lionelbroche/cosi-measure/doc/Publications/README.md

A detailed description of COSI Measure V1.0 with supplementary videos can be found in the following publication:

[H. Han, R. Moritz, E. Oberacker, H. Waiczies, T. Niendorf and L. Winter, "Open Source 3D Multipurpose Measurement System with Submillimetre Fidelity and First Application in Magnetic Resonance", Scientific Reports, 7:13452, 2017](www.nature.com/articles/s41598-017-13824-z)
