lionelbroche/cosi-measure/src/src/Electronics.md

---
Details:
    Thumbnail: images/3Dview.bmp
    Time: 5 days
    Difficulty: Medium
    Skills:
      - Soldering
---

[M4x10 screws]:Parts.yaml#M4x10PanSteel
[No. 2 Phillips screwdriver]:Parts.yaml#Screwdriver_Philips_No2
# COSI-measure: Electronics

{{BOM}}

## Put screws into the widget {pagestep}

* Get a [No. 2 Phillips screwdriver]{Qty: 1, Cat: tool} ready
* Take three [M4x10 screws]{Qty: 3} and screw them into the [widget](widget.md){Qty: 1}

## Put more screws into the widget {pagestep}

* Find the [screwdriver][No. 2 Phillips screwdriver]{Qty: 1, Cat: tool} again
* Take two more [M4x10 screws]{Qty: 2} and screw them into the same widget
