lionelbroche/cosi-measure/doc/photos for Aberdeen/1000128496.jpg

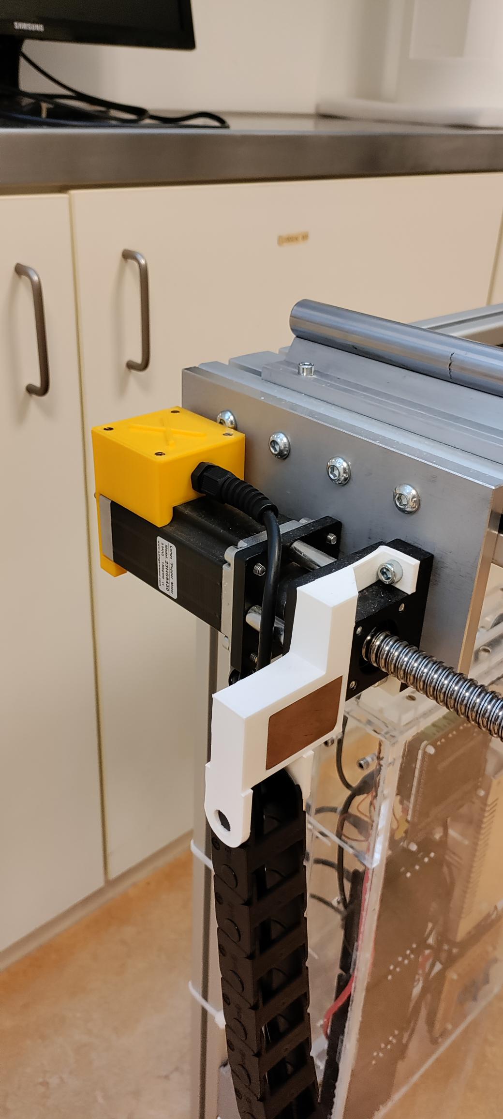
doc/photos for Aberdeen/1000128496.jpg
