lionelbroche/cosi-measure/doc/photos for Aberdeen/1000128497.jpg

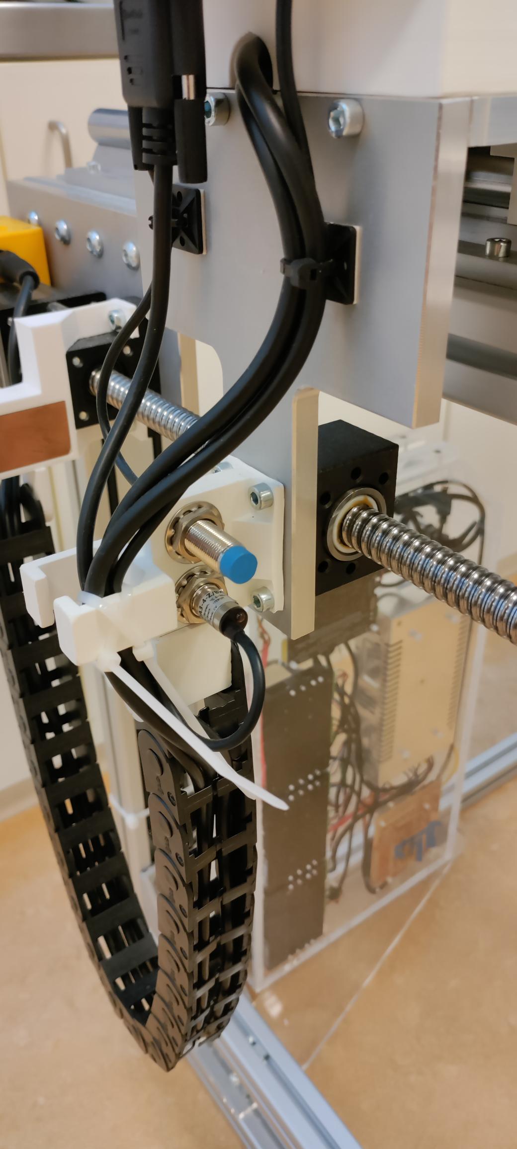
doc/photos for Aberdeen/1000128497.jpg
