lionelbroche/cosi-measure/doc/photos for Aberdeen/1000128498.jpg

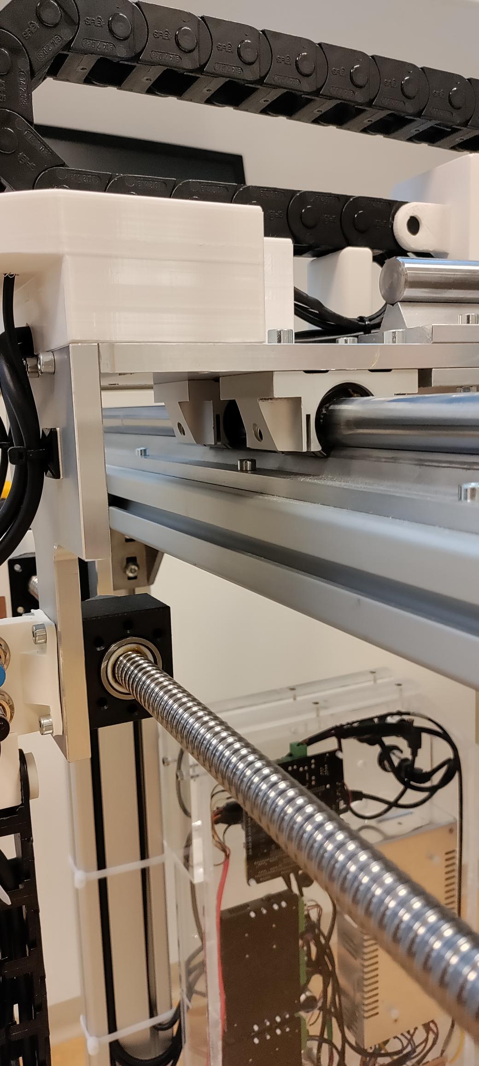
doc/photos for Aberdeen/1000128498.jpg
