lionelbroche/cosi-measure/doc/photos for Aberdeen/1000128499.jpg

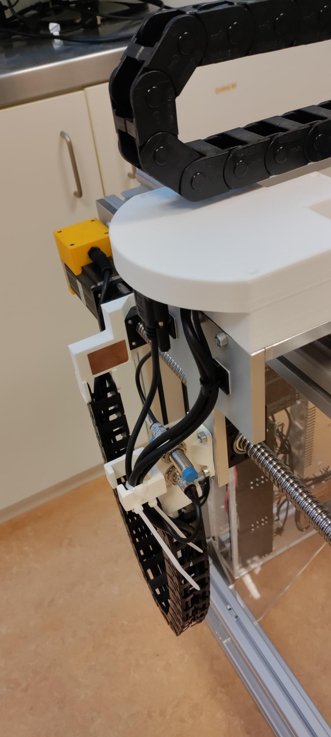
doc/photos for Aberdeen/1000128499.jpg
