lionelbroche/cosi-measure/doc/photos for Aberdeen/1000128500.jpg

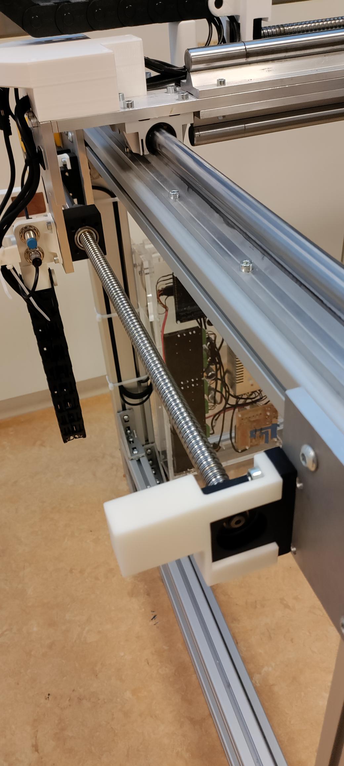
doc/photos for Aberdeen/1000128500.jpg
