lionelbroche/cosi-measure/doc/photos for Aberdeen/1000128501.jpg

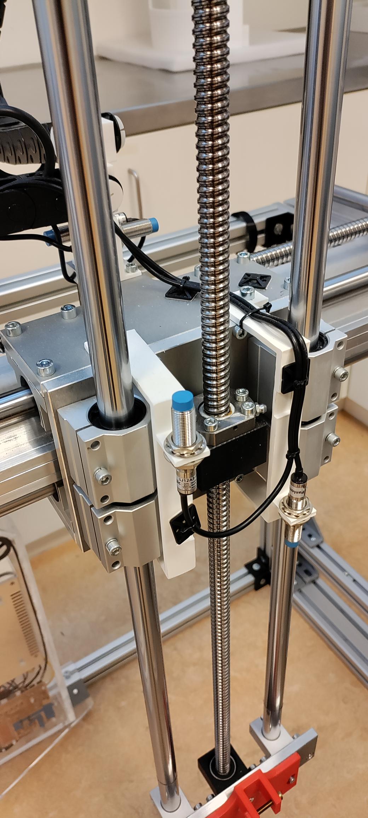
doc/photos for Aberdeen/1000128501.jpg
