lionelbroche/cosi-measure/doc/photos for Aberdeen/1000128502.jpg

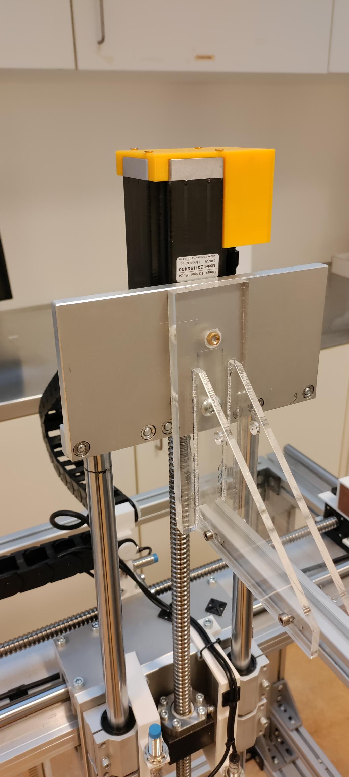
doc/photos for Aberdeen/1000128502.jpg
