lionelbroche/cosi-measure/doc/photos for Aberdeen/1000128503.jpg

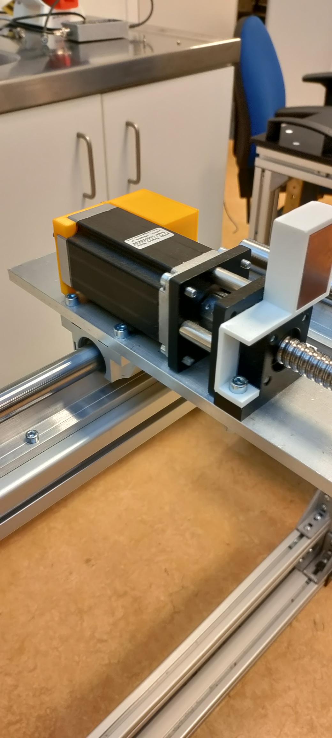
doc/photos for Aberdeen/1000128503.jpg
