lionelbroche/cosi-measure/doc/photos for Aberdeen/1000128504.jpg

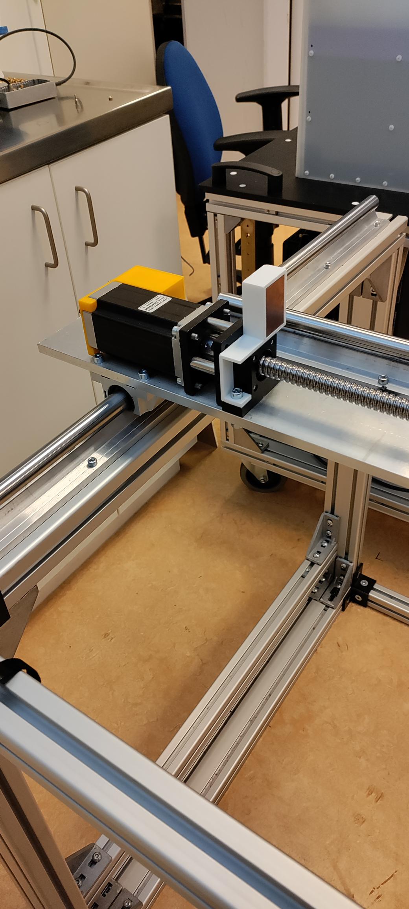
doc/photos for Aberdeen/1000128504.jpg
