lionelbroche/cosi-measure/doc/photos for Aberdeen/1000128505.jpg

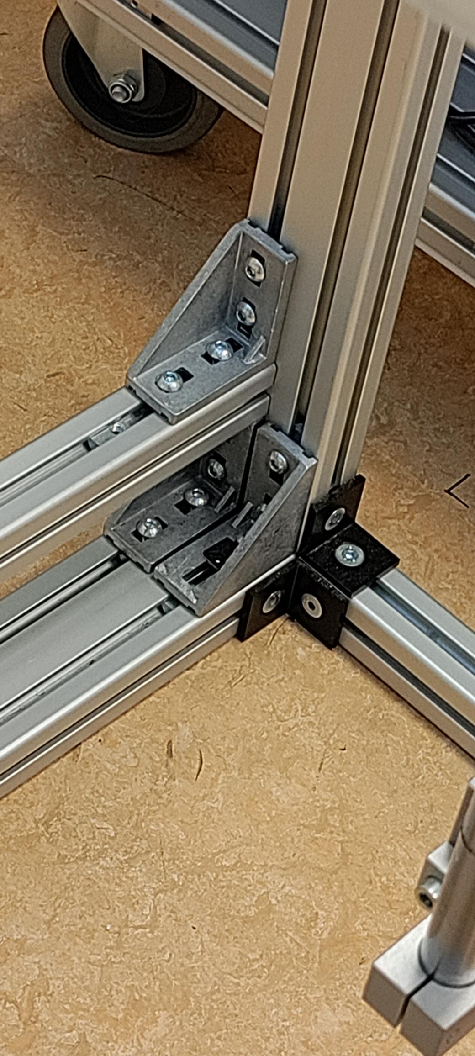
doc/photos for Aberdeen/1000128505.jpg
