lionelbroche/cosi-measure/doc/photos for Aberdeen/1000128506.jpg

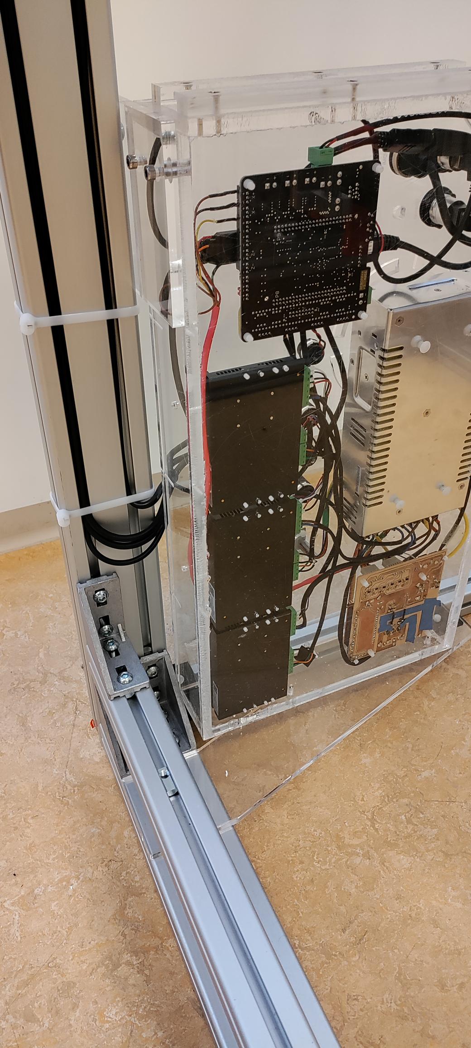
doc/photos for Aberdeen/1000128506.jpg
