lionelbroche/cosi-measure/doc/photos for Aberdeen/1000128507.jpg

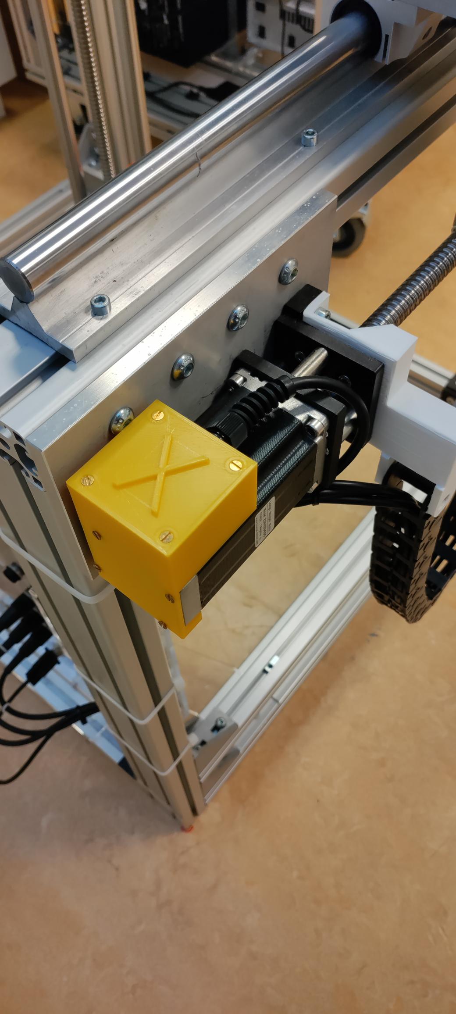
doc/photos for Aberdeen/1000128507.jpg
