lionelbroche/cosi-measure/doc/photos for Aberdeen/1000128508.jpg

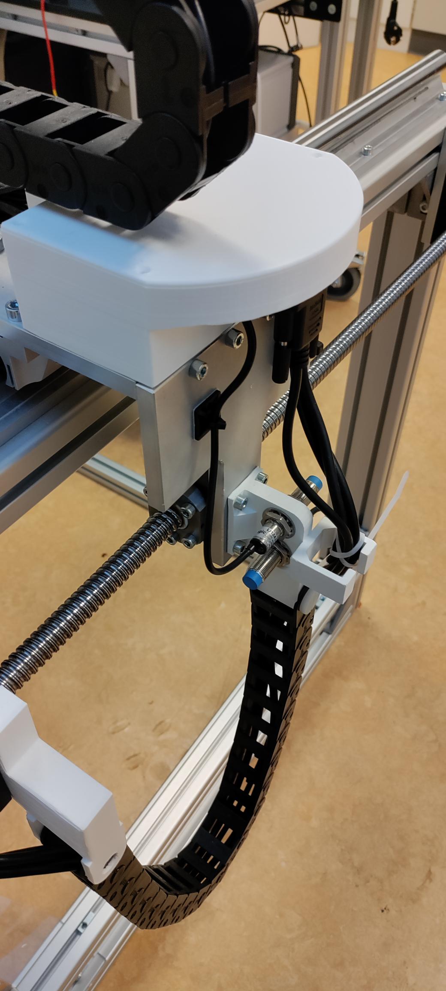
doc/photos for Aberdeen/1000128508.jpg
