lionelbroche/cosi-measure/doc/photos for Aberdeen/1000128509.jpg

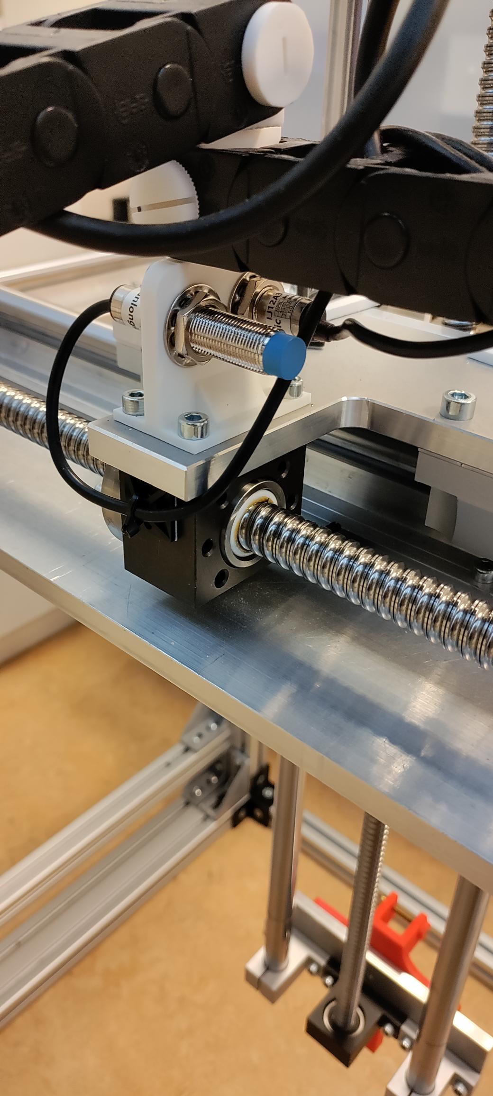
doc/photos for Aberdeen/1000128509.jpg
