lionelbroche/cosi-measure/doc/photos for Aberdeen/1000128510.jpg

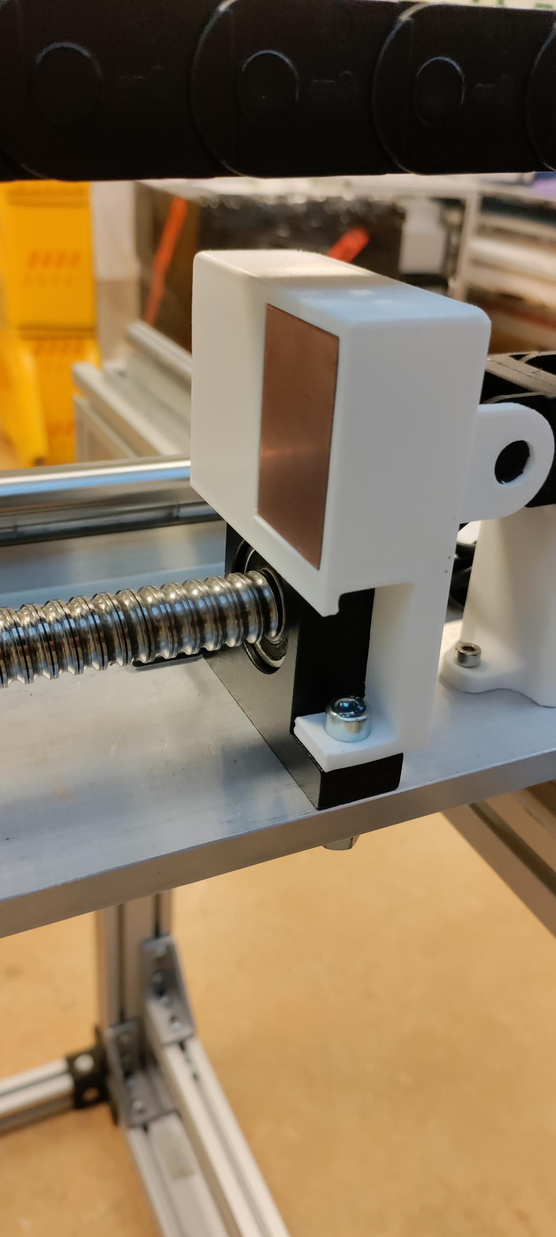
doc/photos for Aberdeen/1000128510.jpg
