lionelbroche/cosi-measure/doc/photos for Aberdeen/1000128511.jpg

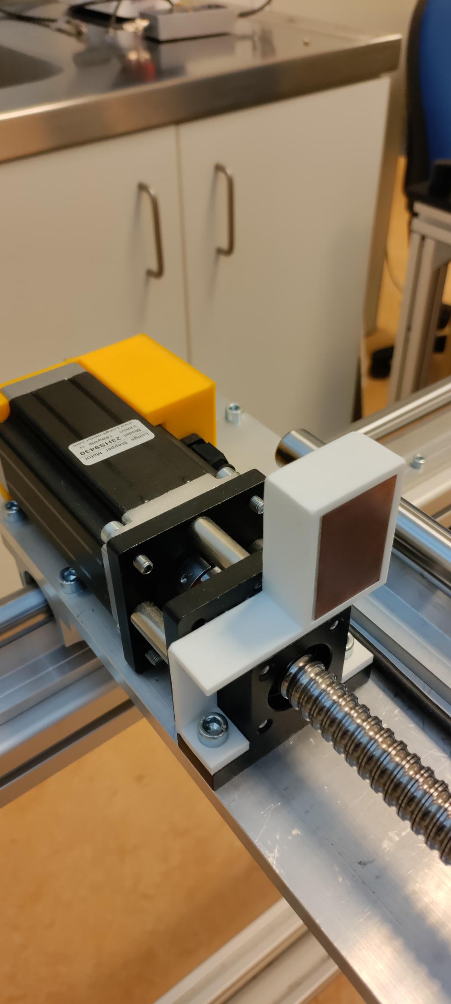
doc/photos for Aberdeen/1000128511.jpg
