lionelbroche/cosi-measure/src/Electronics/electronic cabinet/Rumba32/Endstop_Levelshifter/docs/breakoutboard.png

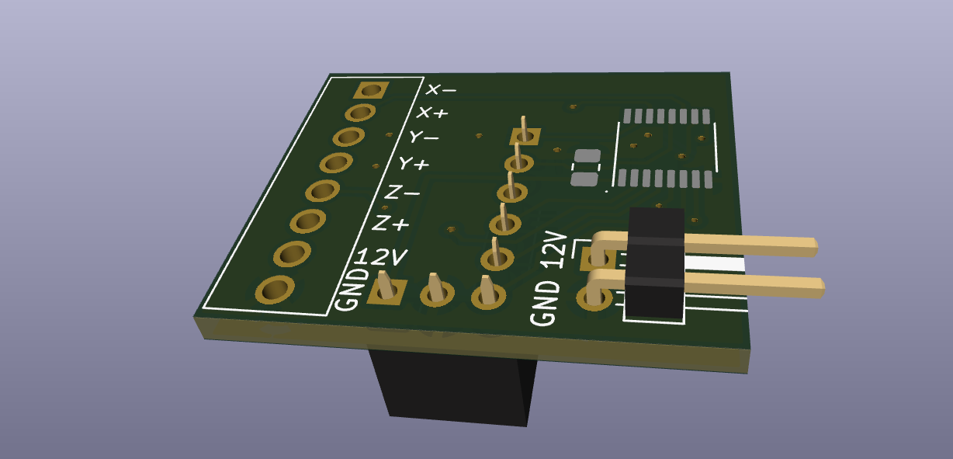
src/Electronics/electronic cabinet/Rumba32/Endstop_Levelshifter/docs/breakoutboard.png
