lionelbroche/cosi-measure/src/Electronics/electronic cabinet/schematics/Emergency-Stop.png

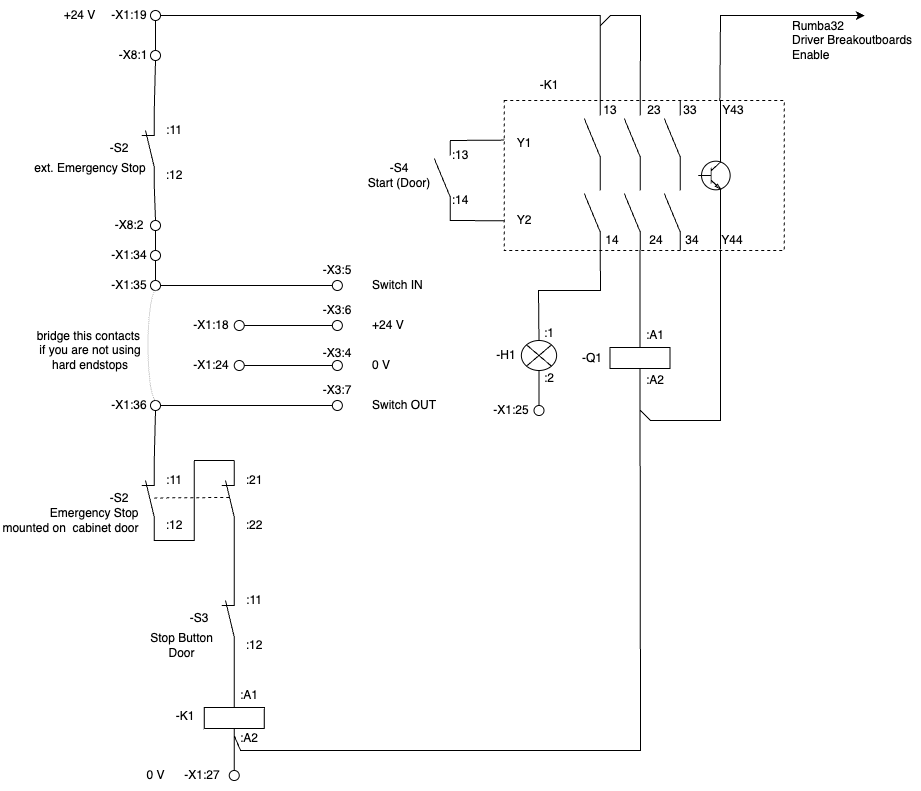
src/Electronics/electronic cabinet/schematics/Emergency-Stop.png
