lionelbroche/cosi-measure/src/Electronics/electronic cabinet/schematics/PowerSupply.png

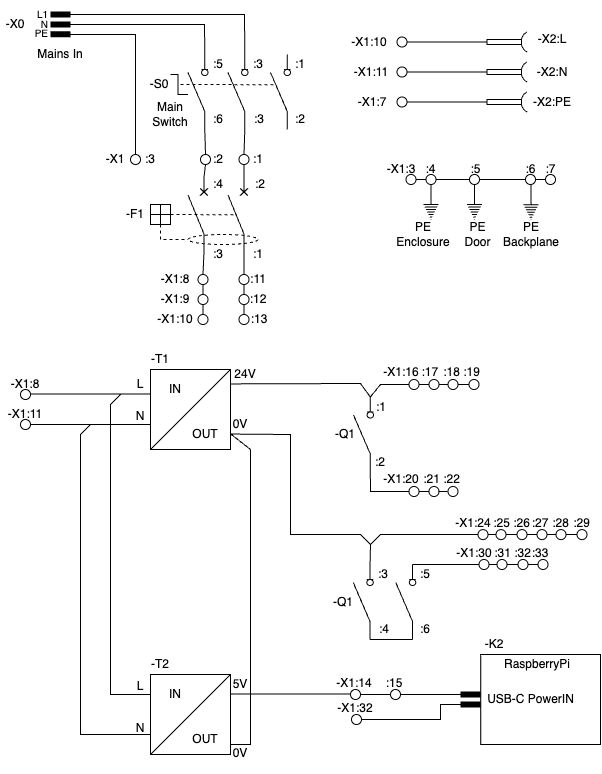
src/Electronics/electronic cabinet/schematics/PowerSupply.png
