lionelbroche/cosi-measure/src/Electronics/electronic cabinet/schematics/RaspberryPi.png

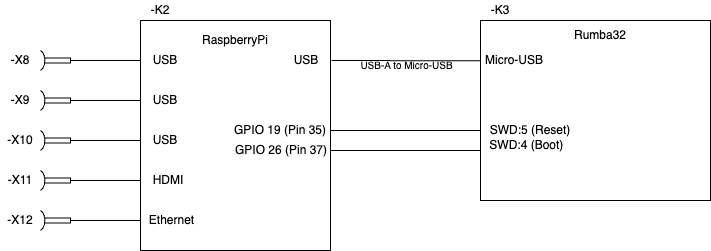
src/Electronics/electronic cabinet/schematics/RaspberryPi.png
