lionelbroche/cosi-measure/src/Electronics/electronic cabinet/schematics/Rumba32.png

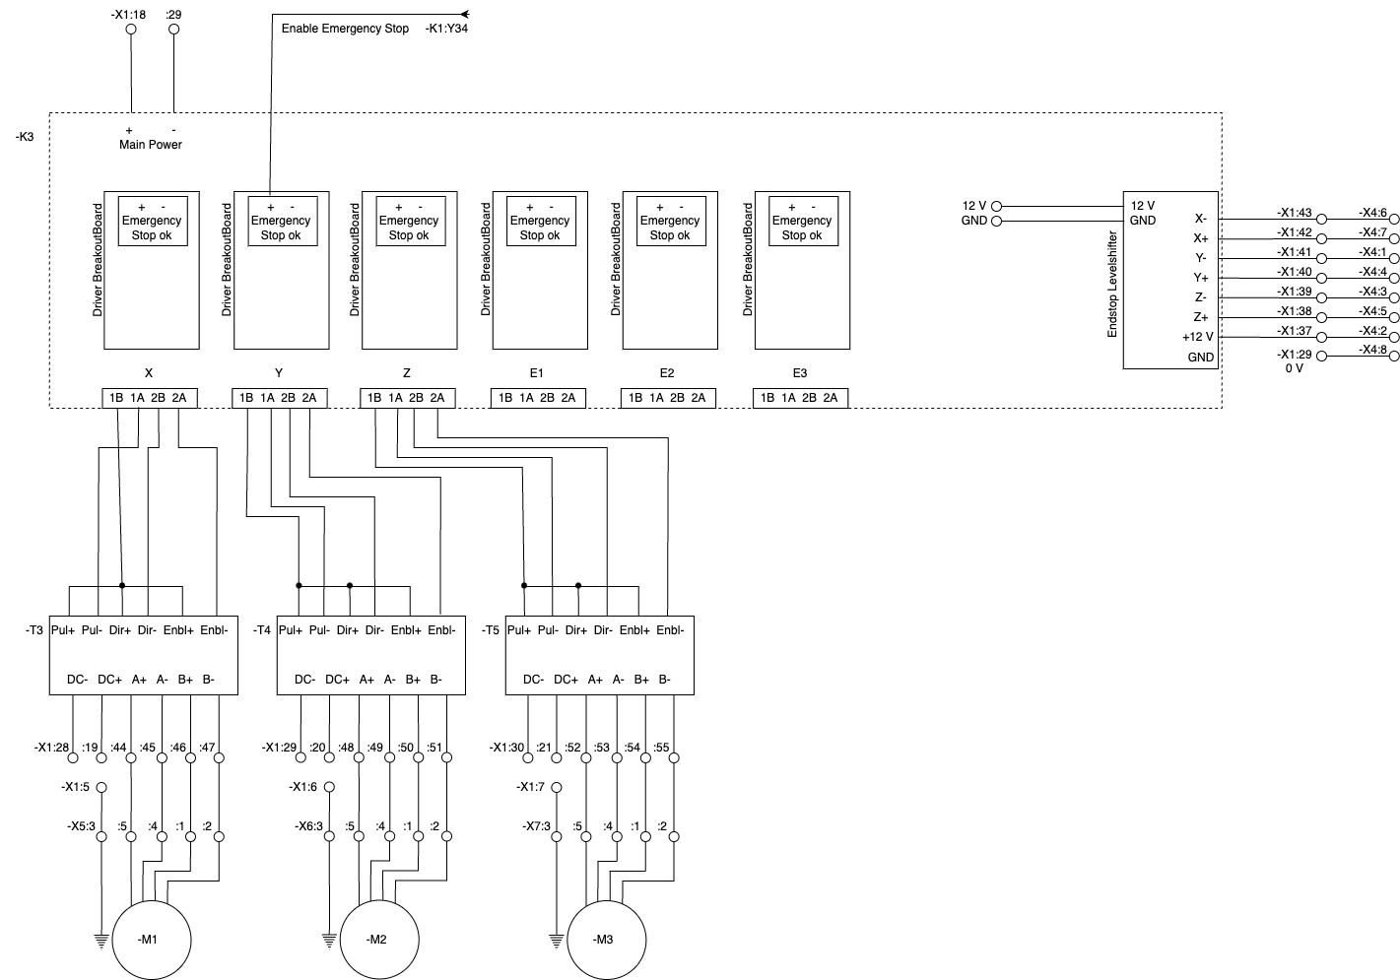
src/Electronics/electronic cabinet/schematics/Rumba32.png
