lionelbroche/cosi-measure/src/Mechanical System/Complete System/design_in_png/complete_system_back.png

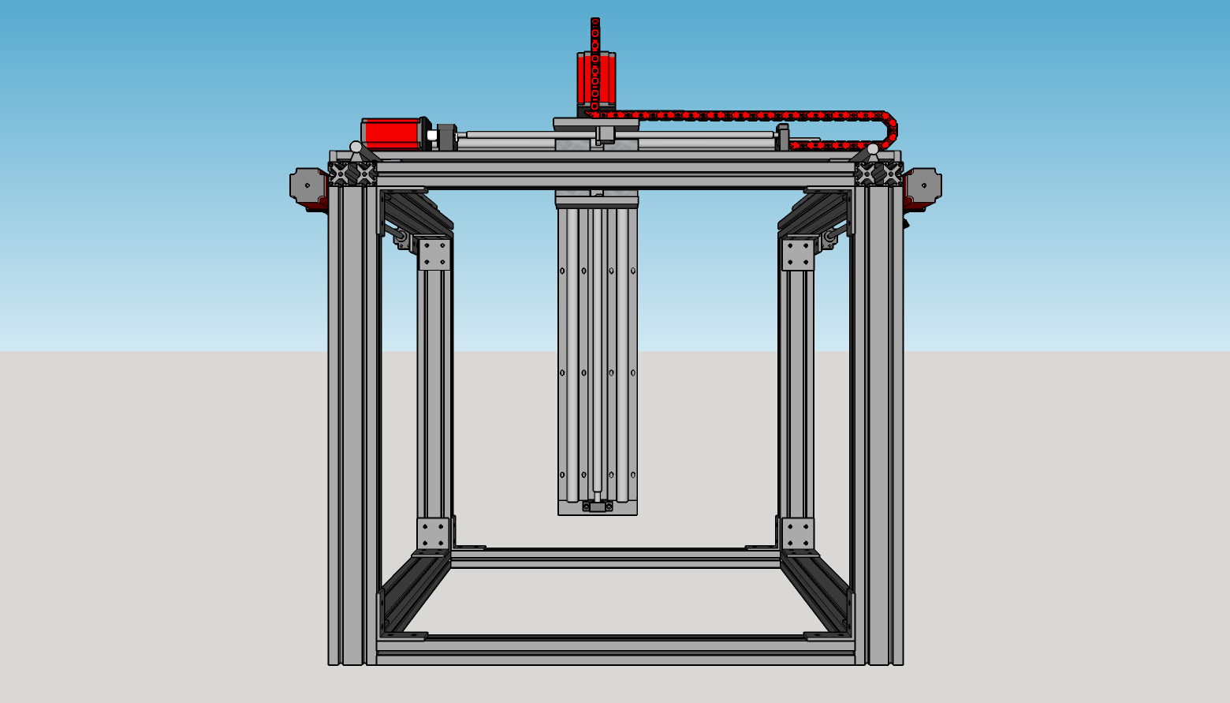
src/Mechanical System/Complete System/design_in_png/complete_system_back.png
