lionelbroche/cosi-measure/src/Mechanical System/Limit Switch Holder v2/cable_chain_holder_y-axis.jpg

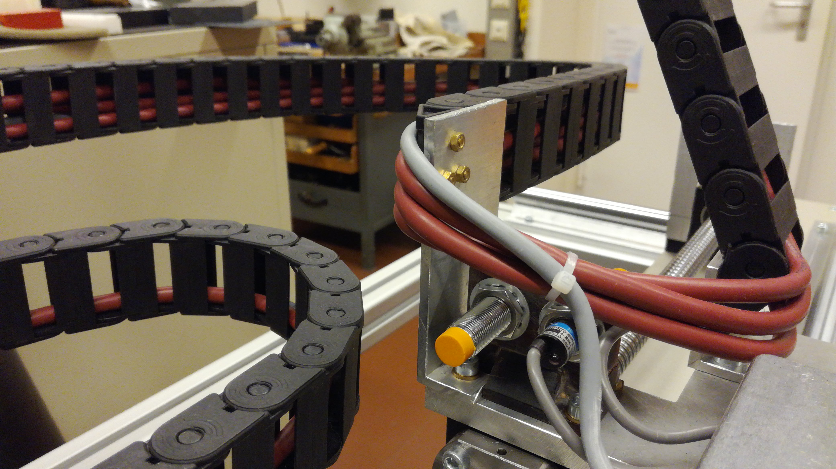
src/Mechanical System/Limit Switch Holder v2/cable_chain_holder_y-axis.jpg
