lionelbroche/cosi-measure/src/Mechanical System/Limit Switch Holder v2/limit_switch_holder_x-axis_1.jpg

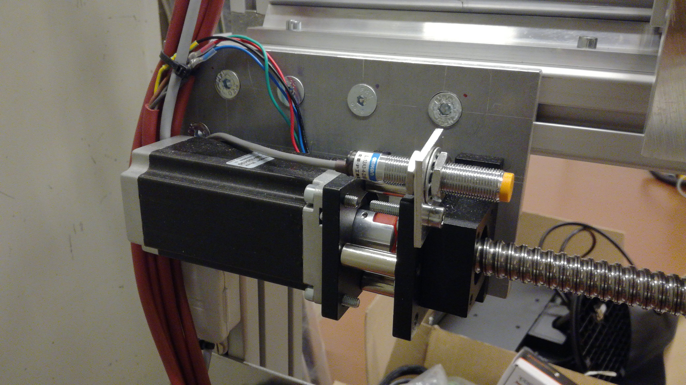
src/Mechanical System/Limit Switch Holder v2/limit_switch_holder_x-axis_1.jpg
