lionelbroche/cosi-measure/src/Mechanical System/Limit Switch Holder v2/limit_switch_holder_y-axis_2.jpg

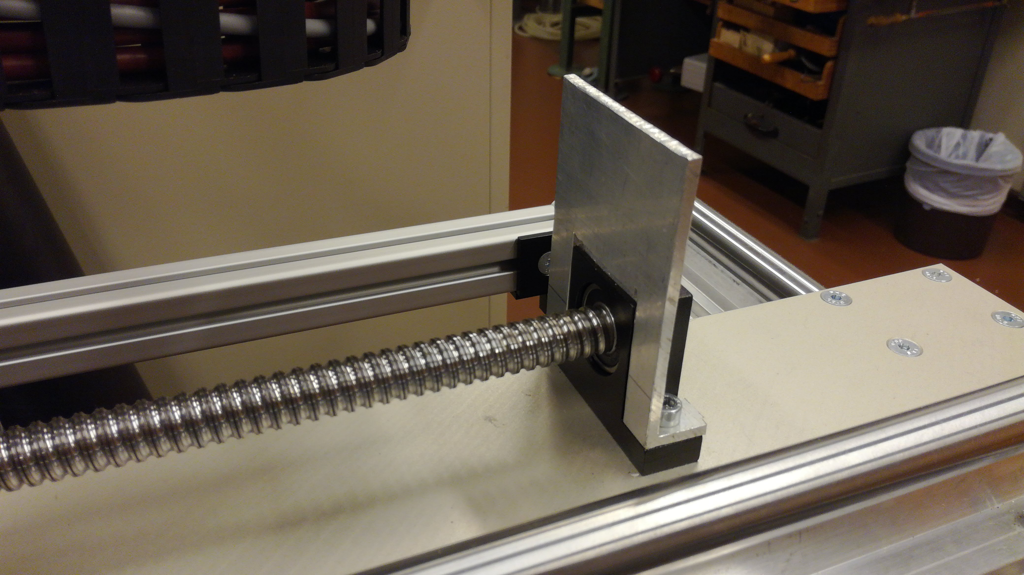
src/Mechanical System/Limit Switch Holder v2/limit_switch_holder_y-axis_2.jpg
