lionelbroche/cosi-measure/src/Mechanical System/Limit Switch Holder v2/limit_switch_holder_z-axis.jpg

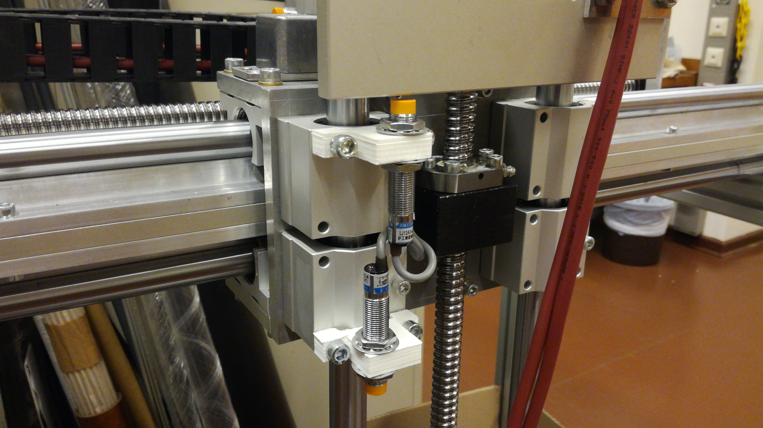
src/Mechanical System/Limit Switch Holder v2/limit_switch_holder_z-axis.jpg
