lionelbroche/cosi-measure/src/src/images/3Dview.bmp

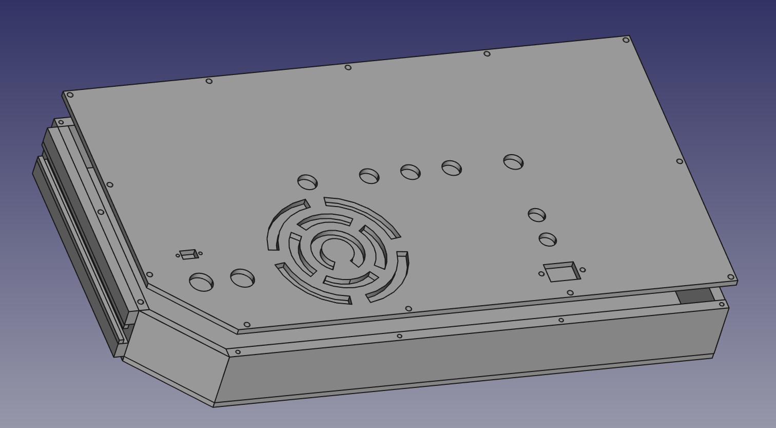
src/src/images/3Dview.bmp
