lionelbroche/cosi-measure/src/src/images/Figure26.png

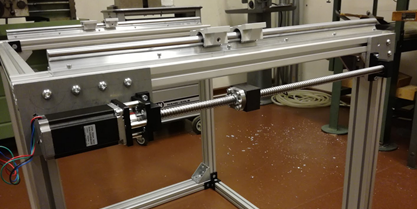
src/src/images/Figure26.png
