lionelbroche/cosi-measure/src/src/images/IntroPic001.jpg

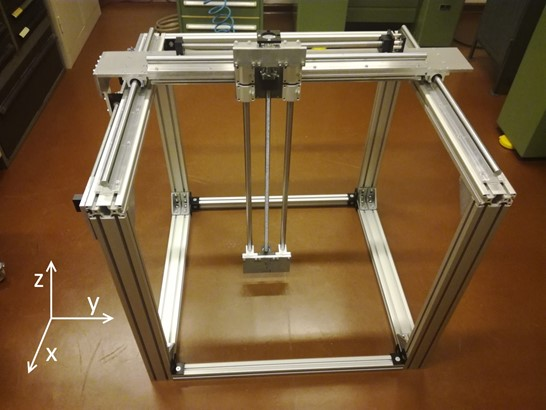
src/src/images/IntroPic001.jpg
