lionelbroche/cosi-measure/src/src/images/RequiresParts.png

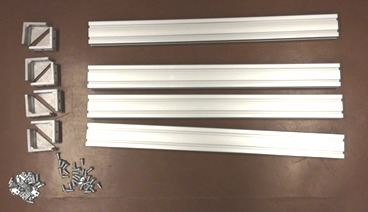
src/src/images/RequiresParts.png
