lionelbroche/cosi-measure/src/Mechanical System/Aluplates/FreeCAD/plate7.FCStd

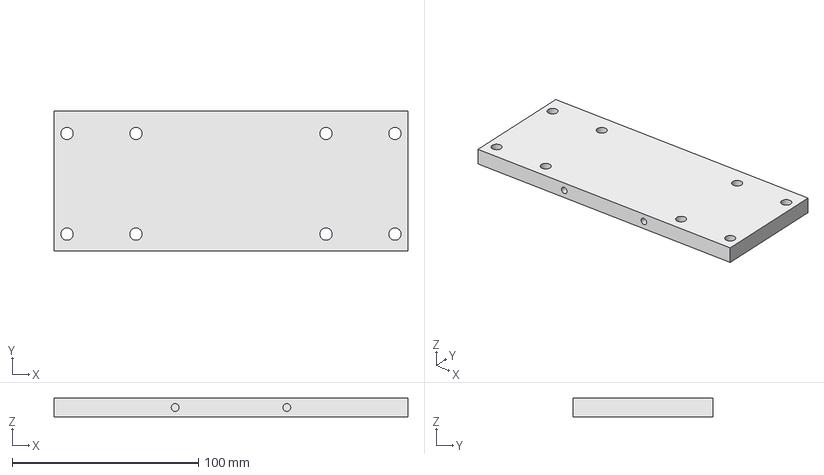
[picture p80: CAD file, 2025-06-25]
src/Mechanical System/Aluplates/FreeCAD/plate7.FCStd
190.0 x 75.0 x 10.0 mm
