lionelbroche/cosi-measure/src/Mechanical System/Limit Switch Holder v2/limit_switch_holder_x-axis_v2.stp

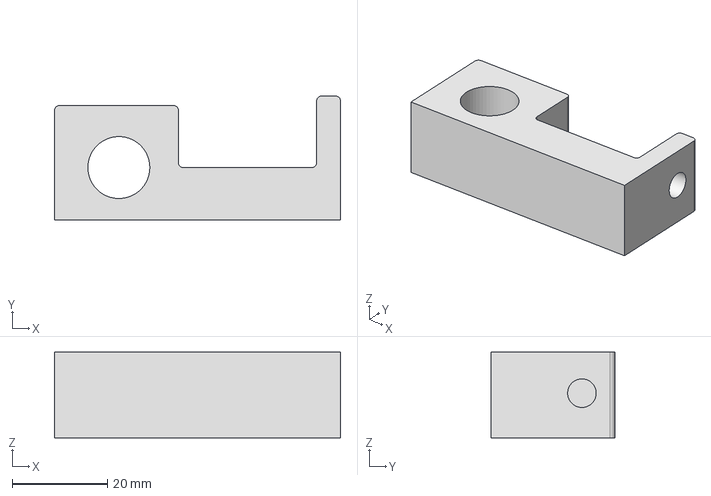
[picture p81: CAD file, 2025-08-13]
src/Mechanical System/Limit Switch Holder v2/limit_switch_holder_x-axis_v2.stp
60.0 x 26.0 x 18.0 mm
