lionelbroche/cosi-measure/src/Mechanical System/Aluplates/FreeCAD/plate4.FCStd

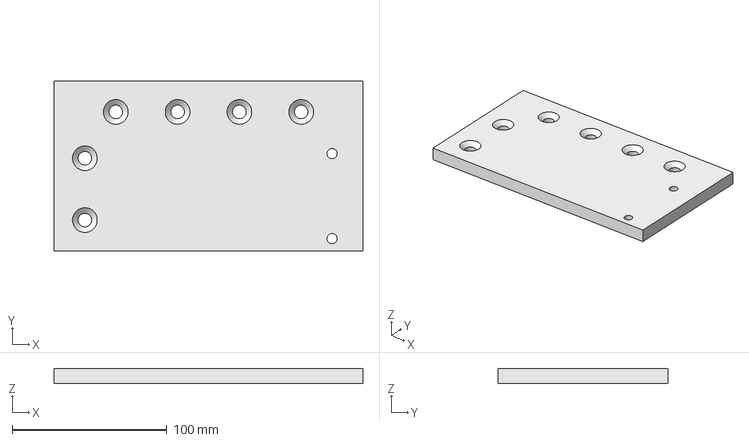
[picture p82: CAD file, 2025-06-25]
src/Mechanical System/Aluplates/FreeCAD/plate4.FCStd
200.0 x 110.0 x 10.0 mm
