lionelbroche/cosi-measure/src/Mechanical System/Limit Switch Holder v2/limit_switch_holder_z-axis_v2.stp

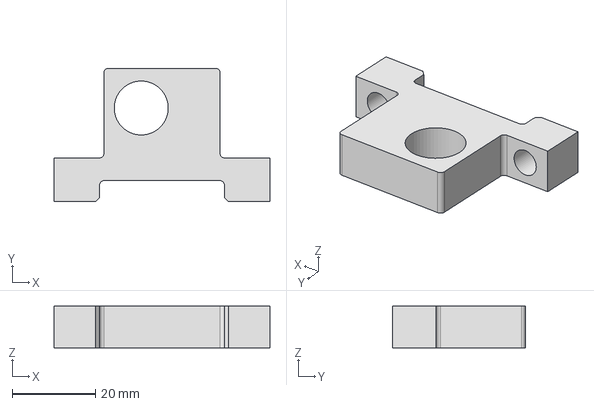
[picture p83: CAD file, 2025-08-13]
src/Mechanical System/Limit Switch Holder v2/limit_switch_holder_z-axis_v2.stp
52.0 x 32.0 x 10.0 mm
