lionelbroche/cosi-measure/src/Mechanical System/Aluplates/FreeCAD/plate2.FCStd

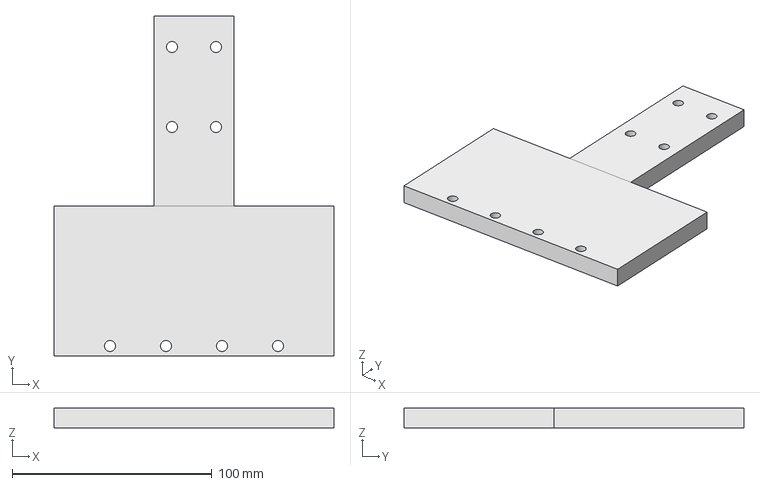
[picture p84: CAD file, 2025-06-25]
src/Mechanical System/Aluplates/FreeCAD/plate2.FCStd
140.0 x 170.0 x 10.0 mm
