lionelbroche/cosi-measure/src/Mechanical System/Aluplates/FreeCAD/plate1.FCStd

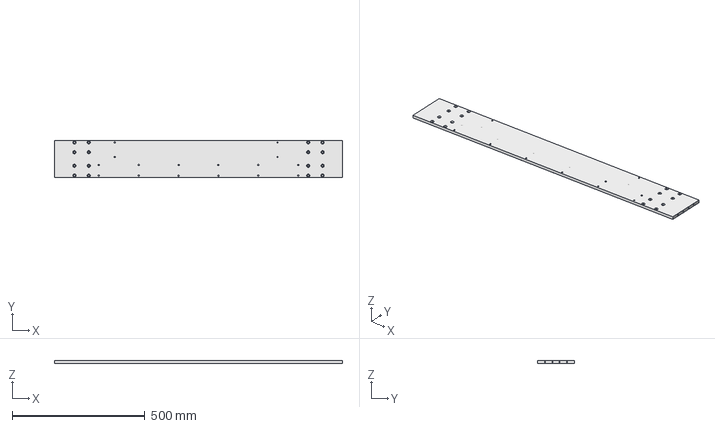
[picture p85: CAD file, 2025-06-25]
src/Mechanical System/Aluplates/FreeCAD/plate1.FCStd
1084.0 x 140.0 x 10.0 mm
