lionelbroche/cosi-measure/src/Mechanical System/Aluplates/FreeCAD/plate3.FCStd

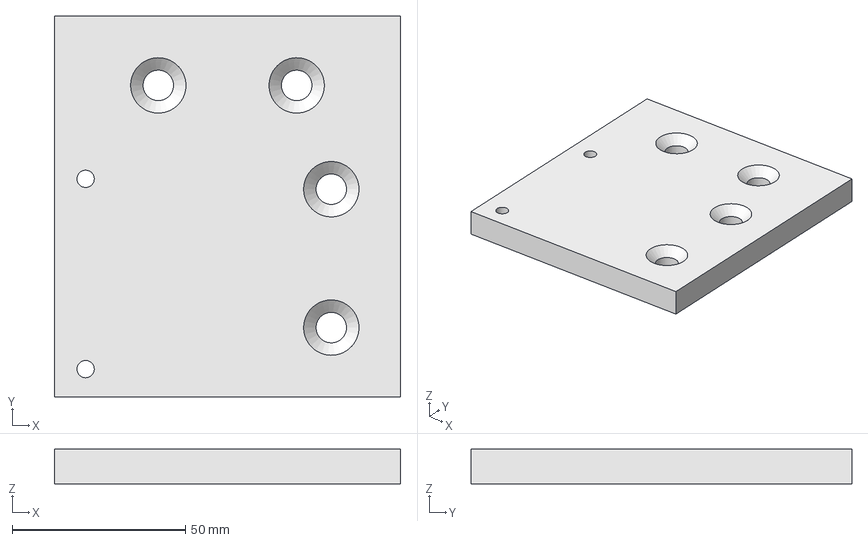
[picture p86: CAD file, 2025-06-25]
src/Mechanical System/Aluplates/FreeCAD/plate3.FCStd
100.0 x 110.0 x 10.0 mm
