lionelbroche/cosi-measure/src/Mechanical System/Aluplates/FreeCAD/plate5.FCStd

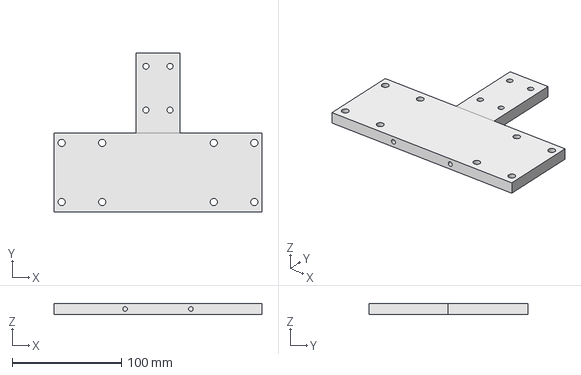
[picture p87: CAD file, 2025-06-25]
src/Mechanical System/Aluplates/FreeCAD/plate5.FCStd
190.0 x 145.0 x 10.0 mm
