lionelbroche/cosi-measure/src/Mechanical System/Aluplates/FreeCAD/plate8.FCStd

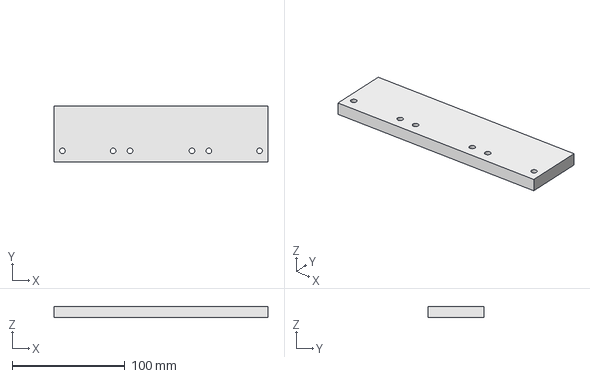
[picture p88: CAD file, 2025-06-25]
src/Mechanical System/Aluplates/FreeCAD/plate8.FCStd
190.0 x 50.0 x 10.0 mm
