lionelbroche/cosi-measure/src/Mechanical System/Aluplates/FreeCAD/plate6.FCStd

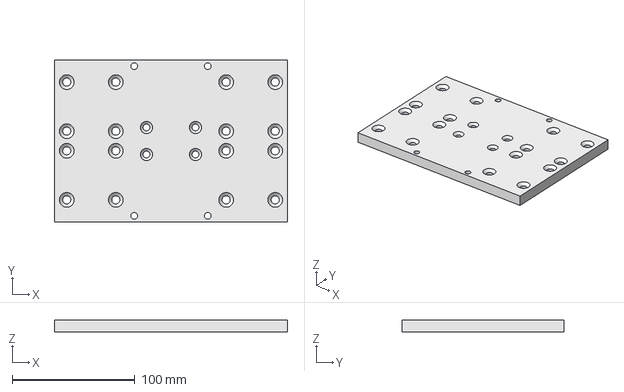
[picture p89: CAD file, 2025-06-25]
src/Mechanical System/Aluplates/FreeCAD/plate6.FCStd
190.0 x 132.0 x 10.0 mm
