lionelbroche/cosi-measure/src/Mechanical System/Aluplates/FreeCAD/plate9.FCStd

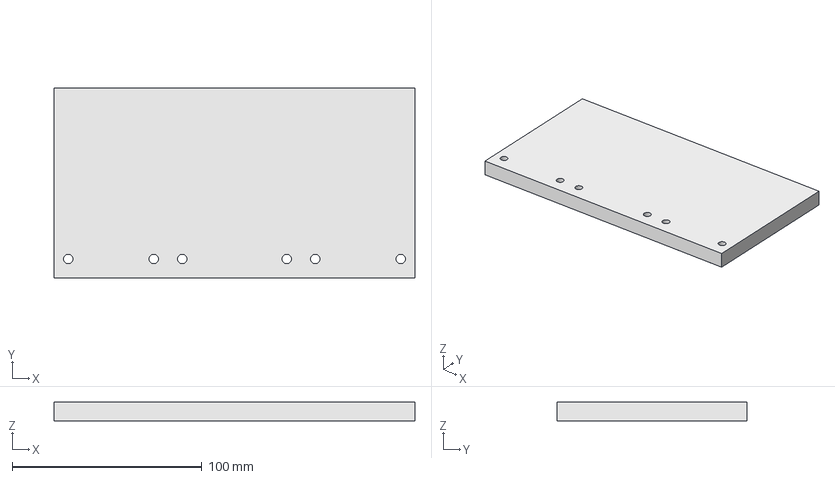
[picture p90: CAD file, 2025-06-25]
src/Mechanical System/Aluplates/FreeCAD/plate9.FCStd
190.0 x 100.0 x 10.0 mm
