lionelbroche/cosi-measure/src/Mechanical System/Limit Switch Holder/Sensor Winkel1_kurz_lang.stl

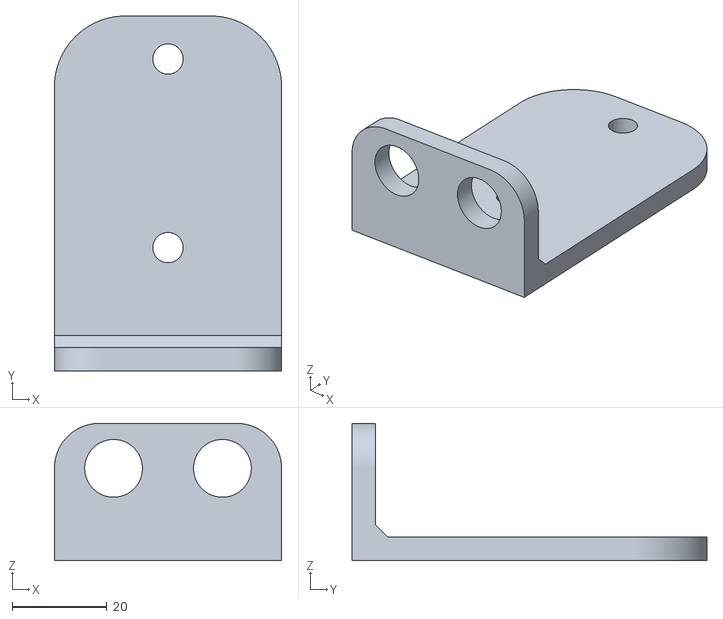
[picture p91: CAD file, 2025-06-25, an earlier design]
src/Mechanical System/Limit Switch Holder/Sensor Winkel1_kurz_lang.stl
48.0 x 75.0 x 29.0
