lionelbroche/cosi-measure/src/Mechanical System/Limit Switch Holder/Sensor Winkel1.stl

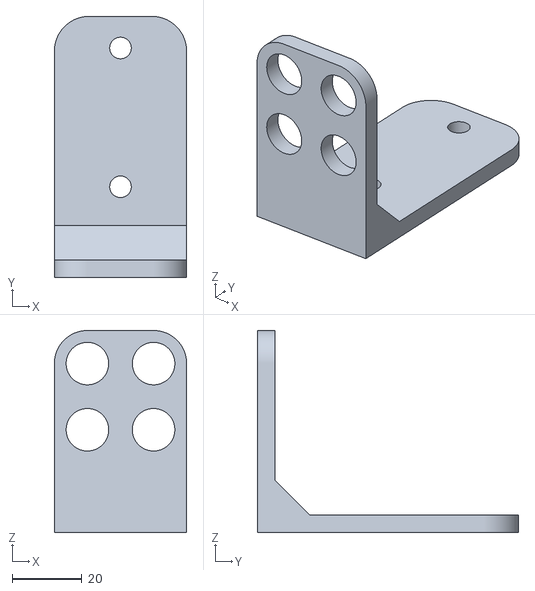
[picture p92: CAD file, 2025-06-25, an earlier design]
src/Mechanical System/Limit Switch Holder/Sensor Winkel1.stl
38.0 x 75.0 x 58.0
