lionelbroche/cosi-measure/src/Mechanical System/Limit Switch Holder/Sensor Winkel1_kurz.stl

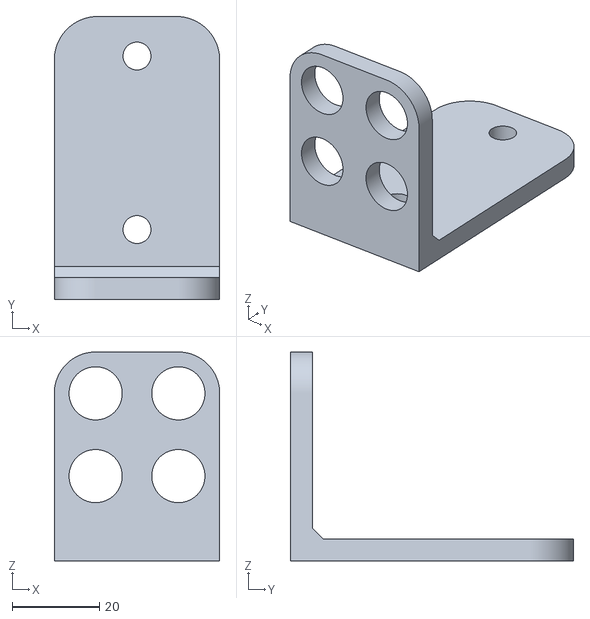
[picture p93: CAD file, 2025-06-25, an earlier design]
src/Mechanical System/Limit Switch Holder/Sensor Winkel1_kurz.stl
38.0 x 65.0 x 48.0
