lionelbroche/cosi-measure/(list of files, cad)

Other CAD files:
src/Mechanical System/Complete System/complete_system.skp
src/Mechanical System/Limit Switch Holder v2/limit_switch_holder_x-axis_v2.stl
src/Mechanical System/Limit Switch Holder v2/limit_switch_holder_z-axis_v2.stl
