lionelbroche/cosi-measure/doc/cosi_measure_builds.jpg

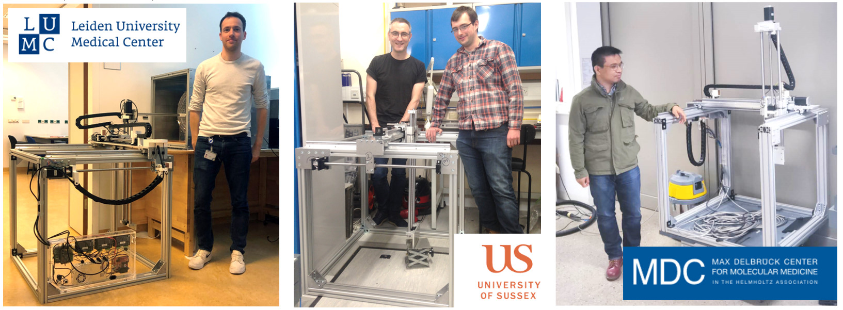
doc/cosi_measure_builds.jpg
