lionelbroche/cosi-measure/src/Software/_demo_data/measurement_1/centerpoint.csv

2.320095693257377718e+02
1.649535239324973759e+02
2.763301362775499115e+02
