lionelbroche/cosi-measure/src/Software/_demo_data/measurement_1/raw_dat.csv

X[mm] | Y[mm] | Z[mm] | Bx[mT] | By[mT] | Bz[mT]
254.38 | 133.64 | 200.28 | -47.491000 | -2.026000 | -0.077000
245.43 | 133.64 | 200.28 | -47.492000 | -2.037000 | -0.065000
236.48 | 133.64 | 200.28 | -47.489000 | -2.045000 | -0.073000
227.54 | 133.64 | 200.28 | -47.494000 | -2.053000 | -0.058000
209.64 | 142.59 | 200.28 | -47.507000 | -2.060000 | -0.061000
218.59 | 142.59 | 200.28 | -47.512000 | -2.056000 | -0.051000
227.54 | 142.59 | 200.28 | -47.506000 | -2.052000 | -0.057000
236.48 | 142.59 | 200.28 | -47.495000 | -2.046000 | -0.061000
245.43 | 142.59 | 200.28 | -47.495000 | -2.038000 | -0.070000
254.38 | 142.59 | 200.28 | -47.492000 | -2.028000 | -0.074000
272.27 | 151.53 | 200.28 | -47.504000 | -2.024000 | -0.064000
263.33 | 151.53 | 200.28 | -47.506000 | -2.015000 | -0.067000
254.38 | 151.53 | 200.28 | -47.502000 | -2.027000 | -0.074000
245.43 | 151.53 | 200.28 | -47.495000 | -2.039000 | -0.071000
236.48 | 151.53 | 200.28 | -47.500000 | -2.036000 | -0.071000
227.54 | 151.53 | 200.28 | -47.496000 | -2.046000 | -0.061000
218.59 | 151.53 | 200.28 | -47.504000 | -2.048000 | -0.064000
209.64 | 151.53 | 200.28 | -47.510000 | -2.054000 | -0.046000
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
