lionelbroche/cosi-measure/doc/cosi_measure_photo.jpg

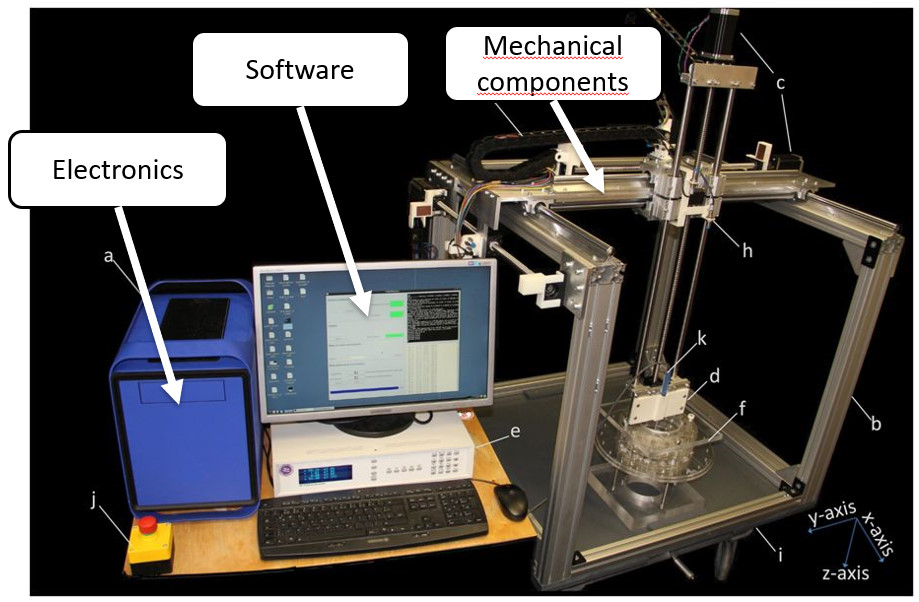
doc/cosi_measure_photo.jpg
