lionelbroche/cosi-measure/src/Electronics/electronic cabinet/Rumba32/Endstop_Levelshifter/Endstop_Levelshifter/Endstop_Levelshifter.kicad_pcb

## KiCad design src/Electronics/electronic cabinet/Rumba32/Endstop_Levelshifter/Endstop_Levelshifter/Endstop_Levelshifter.kicad_pcb (2025-06-25)

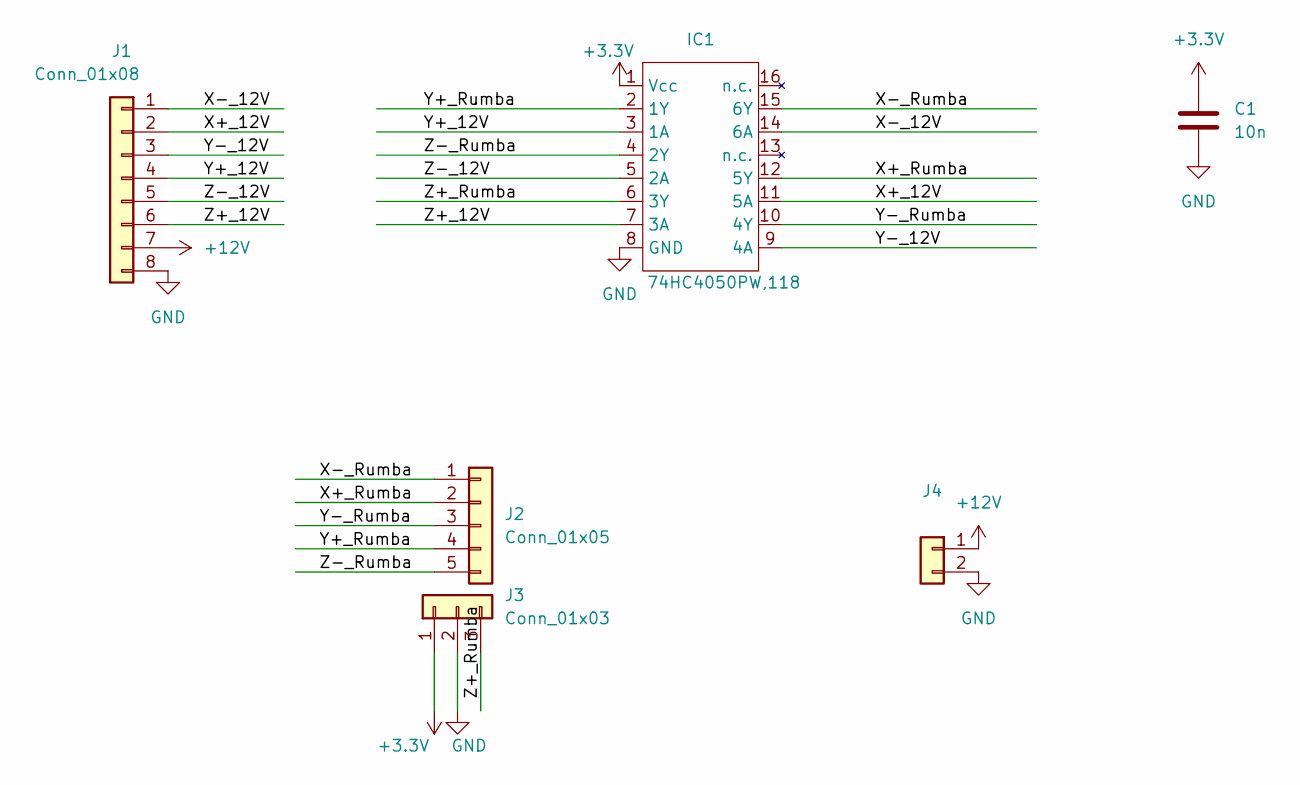
[picture p131: schematic Endstop_Levelshifter.kicad_sch, Endstop Levelshifter 12V]

Parts:
C1: 10n; C_0805_2012Metric_Pad1.18x1.45mm_HandSolder
IC1: 74HC4050PW,118; TSSOP-16_4.4x5mm_P0.65mm
J1: Conn_01x08; 691210910008
J2: Conn_01x05; PinSocket_1x05_P2.54mm_Vertical
J3: Conn_01x03; PinSocket_1x03_P2.54mm_Vertical
J4: Conn_01x02; PinHeader_1x02_P2.54mm_Horizontal

Connections:
+3.3V: C1.1, IC1.1 (Vcc), J3.1
+12V: J1.7, J4.1
/X+_12V: IC1.11 (5A), J1.2
/X+_Rumba: IC1.12 (5Y), J2.2
/X-_12V: IC1.14 (6A), J1.1
/X-_Rumba: IC1.15 (6Y), J2.1
/Y+_12V: IC1.3 (1A), J1.4
/Y+_Rumba: IC1.2 (1Y), J2.4
/Y-_12V: IC1.9 (4A), J1.3
/Y-_Rumba: IC1.10 (4Y), J2.3
/Z+_12V: IC1.7 (3A), J1.6
/Z+_Rumba: IC1.6 (3Y), J3.3
/Z-_12V: IC1.5 (2A), J1.5
/Z-_Rumba: IC1.4 (2Y), J2.5
GND: C1.2, IC1.8 (GND), J1.8, J3.2, J4.2

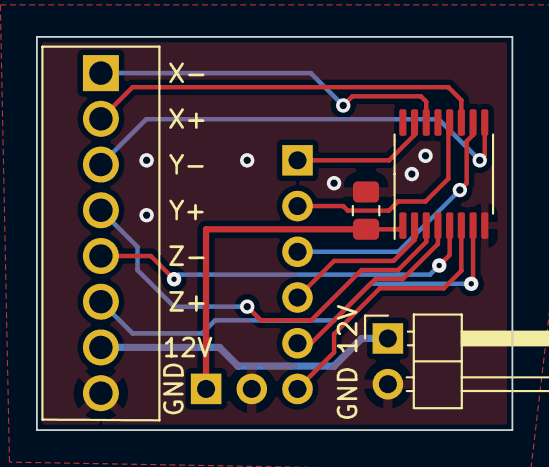
[picture p132: board Endstop_Levelshifter.kicad_pcb from above]

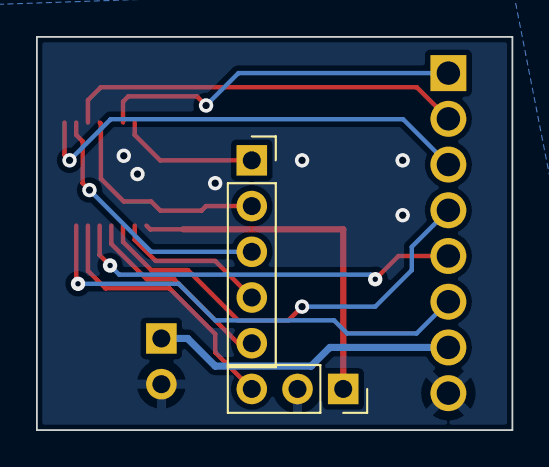
[picture p133: board Endstop_Levelshifter.kicad_pcb from below]

Board: 2 copper layers, 26.4 x 21.8 mm, 6 parts (2 on the bottom side), 15 nets.
