lionelbroche/cosi-measure/src/Electronics/electronic cabinet/Rumba32/Driver_BreakoutBoard/Driver_BreakoutBoard.kicad_pcb

## KiCad design src/Electronics/electronic cabinet/Rumba32/Driver_BreakoutBoard/Driver_BreakoutBoard.kicad_pcb (2025-06-25)

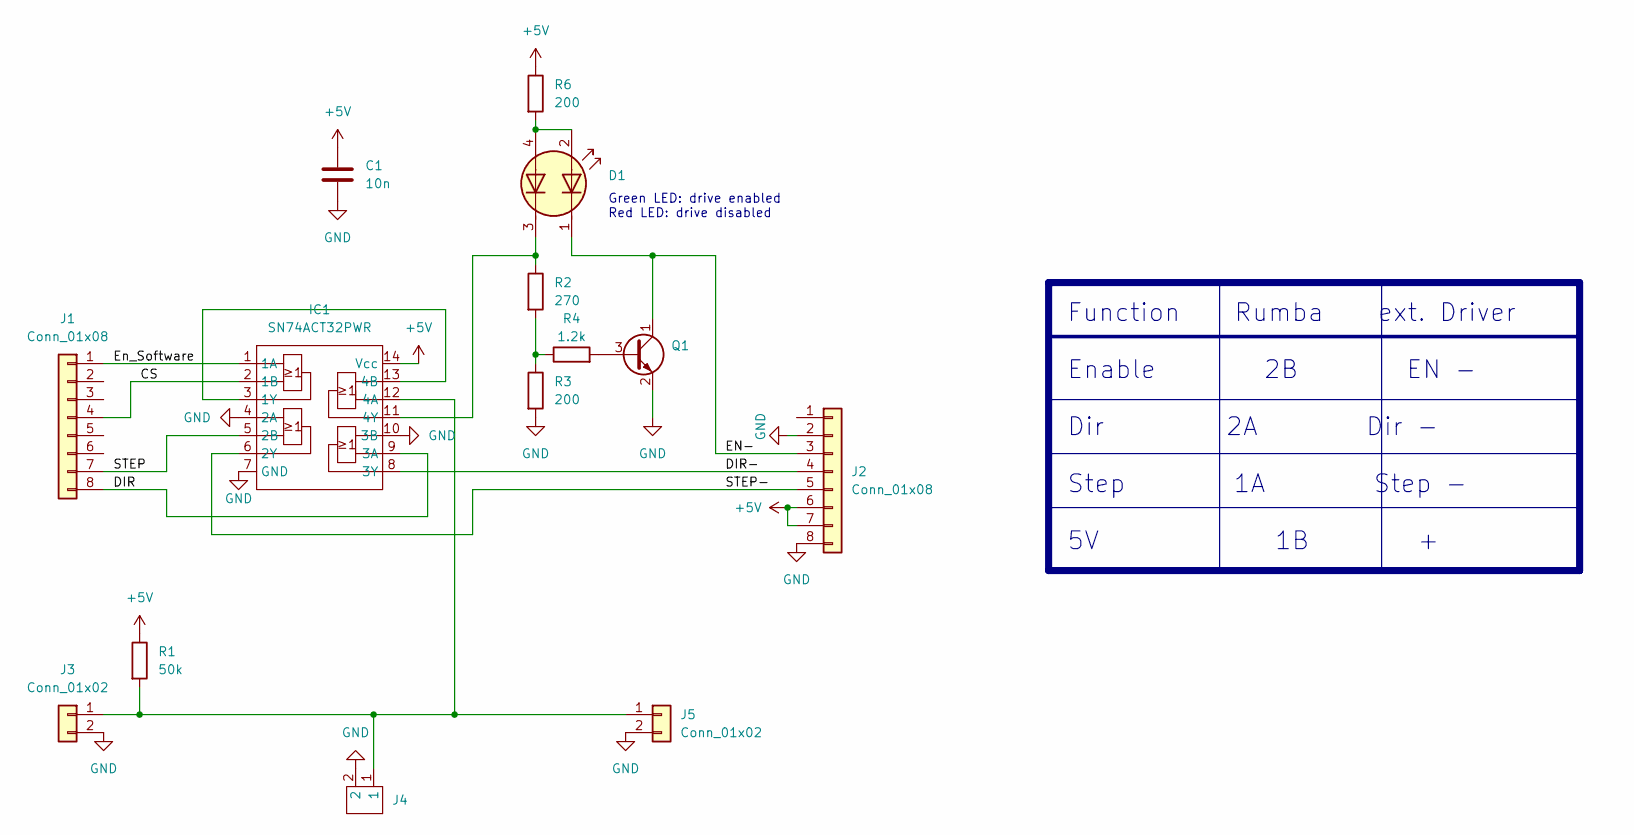
[picture p134: schematic Driver_BreakoutBoard.kicad_sch, Driver BreakoutBoard for ext. Motor Drivers]

Parts:
C1: 10n; C_0805_2012Metric_Pad1.18x1.45mm_HandSolder
D1: LED_Dual; LED_Kingbright_AAA3528ESGCT
IC1: SN74ACT32PWR; SOT402-1_NXP-M
J1, J2: Conn_01x08; PinHeader_1x08_P2.54mm_Vertical
J3, J5: Conn_01x02; PinHeader_1x02_P2.54mm_Vertical
J4: 0393570002
Q1: Q_NPN_CEB; SOT-23_Handsoldering
R1: 50k; R_0805_2012Metric_Pad1.20x1.40mm_HandSolder
R2: 270; R_0805_2012Metric_Pad1.20x1.40mm_HandSolder
R3, R6: 200; R_0805_2012Metric_Pad1.20x1.40mm_HandSolder
R4: 1.2k; R_0805_2012Metric_Pad1.20x1.40mm_HandSolder

Connections:
+5V: C1.1, IC1.14 (Vcc), J2.6, J2.7, R1.1, R6.1
/CS: IC1.2 (1B), J1.4
/DIR: IC1.9 (3A), J1.8
/DIR-: IC1.8 (3Y), J2.4
/EN-: D1.1 (A1), J2.3, Q1.1 (C)
/En_Software: IC1.1 (1A), J1.1
/STEP: IC1.5 (2B), J1.7
/STEP-: IC1.6 (2Y), J2.5
GND: C1.2, IC1.4 (2A), IC1.7 (GND), IC1.10 (3B), J2.2, J2.8, J3.2, J4.2, J5.2, Q1.2 (E), R3.2
unnamed: D1.3 (A2), IC1.11 (4Y), R2.1
unnamed: IC1.3 (1Y), IC1.13 (4B)
unnamed: IC1.12 (4A), J3.1, J4.1, J5.1, R1.2
unnamed: Q1.3 (B), R4.2
unnamed: R2.2, R3.1, R4.1
unnamed: D1.2 (K1), D1.4 (K2), R6.2

Notes on the sheet:
Function Rumba ext. Driver Enable 2B EN - Dir 2A Dir - Step 1A Step - 5V 1B +
Green LED: drive enabled Red LED: drive disabled

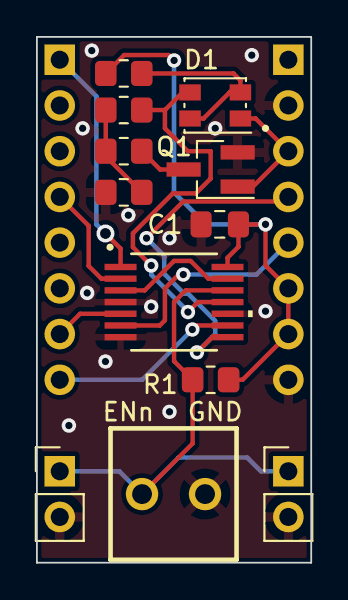
[picture p135: board Driver_BreakoutBoard.kicad_pcb from above]

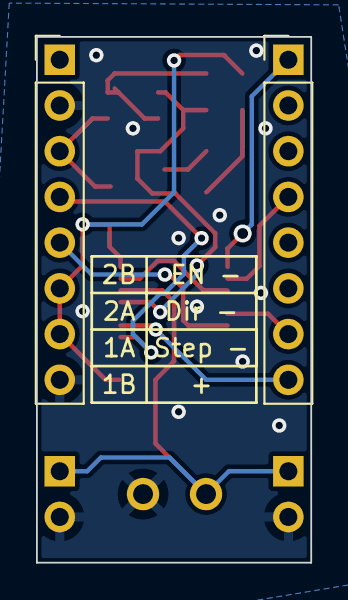
[picture p136: board Driver_BreakoutBoard.kicad_pcb from below]

Board: 2 copper layers, 15.2 x 29.2 mm, 14 parts (2 on the bottom side), 15 nets.
