lionelbroche/cosi-measure/(commit log)

2025-06-25 Structuring the package to ORSHARDS standards
    [2018-08-24_cosi-measure_v1.0_BoM_mechanical.ods, Driver_BreakoutBoard.kicad_pcb, Driver_BreakoutBoard.kicad_sch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]
2025-08-13 Adding instructions for the electronics wiring
    Organising the documentation for the electronics and wiring of the system, and adding some descriptions of the wiring assembly
    [limit_switch_holder_x-axis_v2.stp, limit_switch_holder_z-axis_v2.stp]
2025-08-13 Including additional parts to be made for the wiring
    [limit_switch_holder_x-axis_v2.stl, limit_switch_holder_z-axis_v2.stl]
2025-08-15 adding new info to electronic instructions
    [bom-electronic-cabinet.csv]
